OpenElectronicsLab/eeg-mouse-notes/README

Notes and data from the development of the eeg-mouse project

git@github.com:ericherman/eeg-mouse.git
