OpenElectronicsLab/eeg-mouse-notes/images/OpenHardwareExG-family-picture-800px.jpg

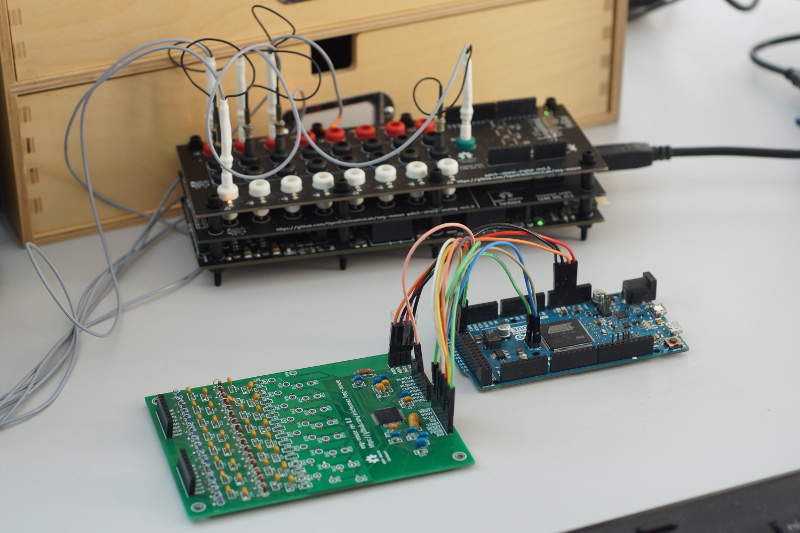
images/OpenHardwareExG-family-picture-800px.jpg
