OpenElectronicsLab/eeg-mouse-notes/images/OpenHardwareExG_rev0.0_level-shifter_arduino-mega.800.jpg

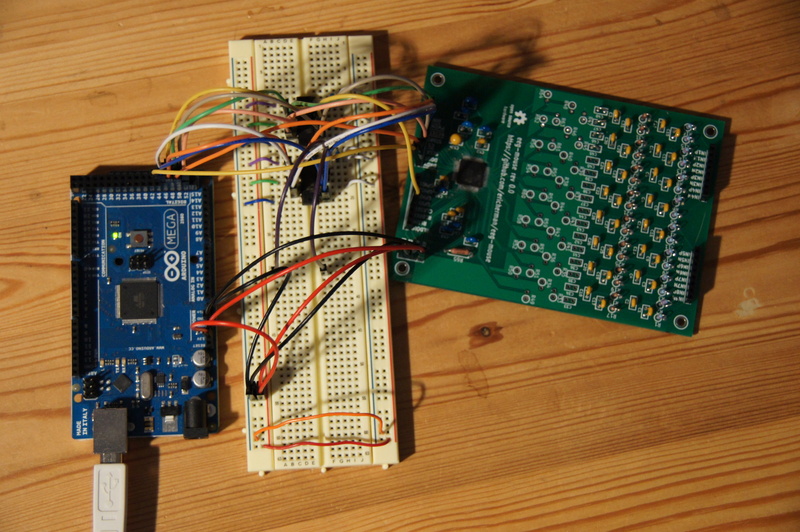
images/OpenHardwareExG_rev0.0_level-shifter_arduino-mega.800.jpg
