OpenElectronicsLab/eeg-mouse-notes/images/rev0-and-due-800px.jpg

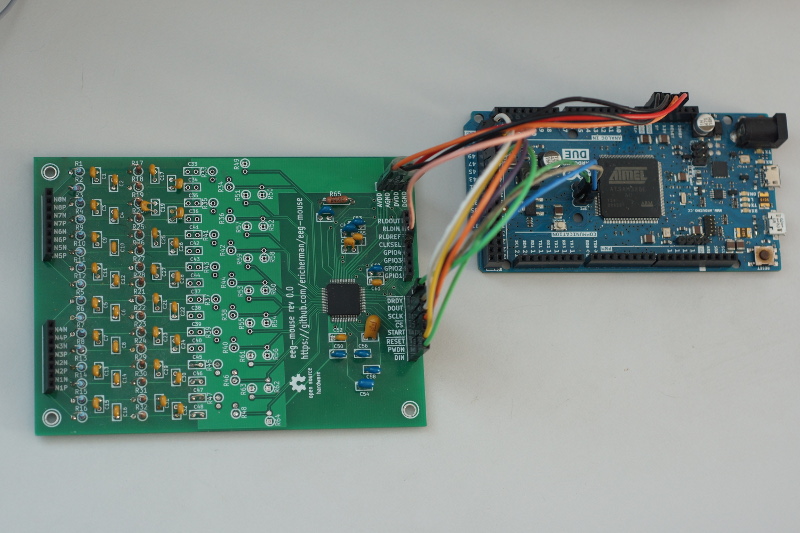
images/rev0-and-due-800px.jpg
