OpenElectronicsLab/eeg-mouse-notes/images/rev1-stack-800px.jpg

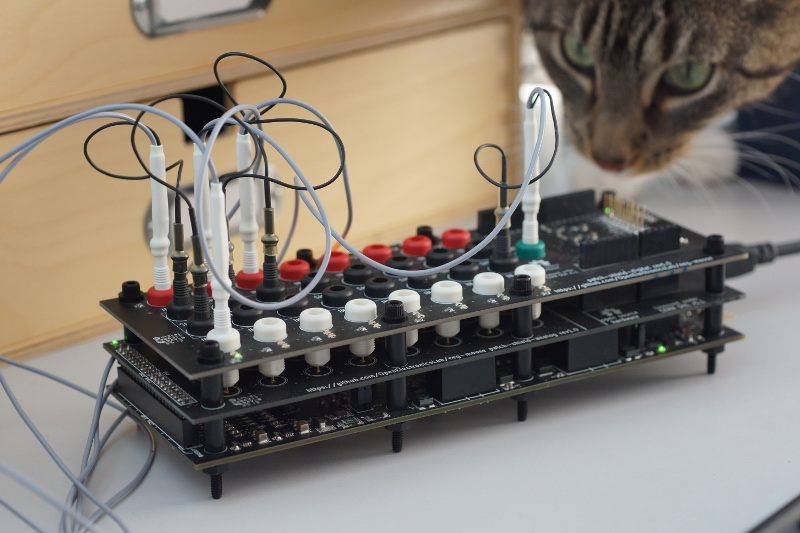
images/rev1-stack-800px.jpg
