OpenElectronicsLab/eeg-mouse-notes/sandbox/ecg.png

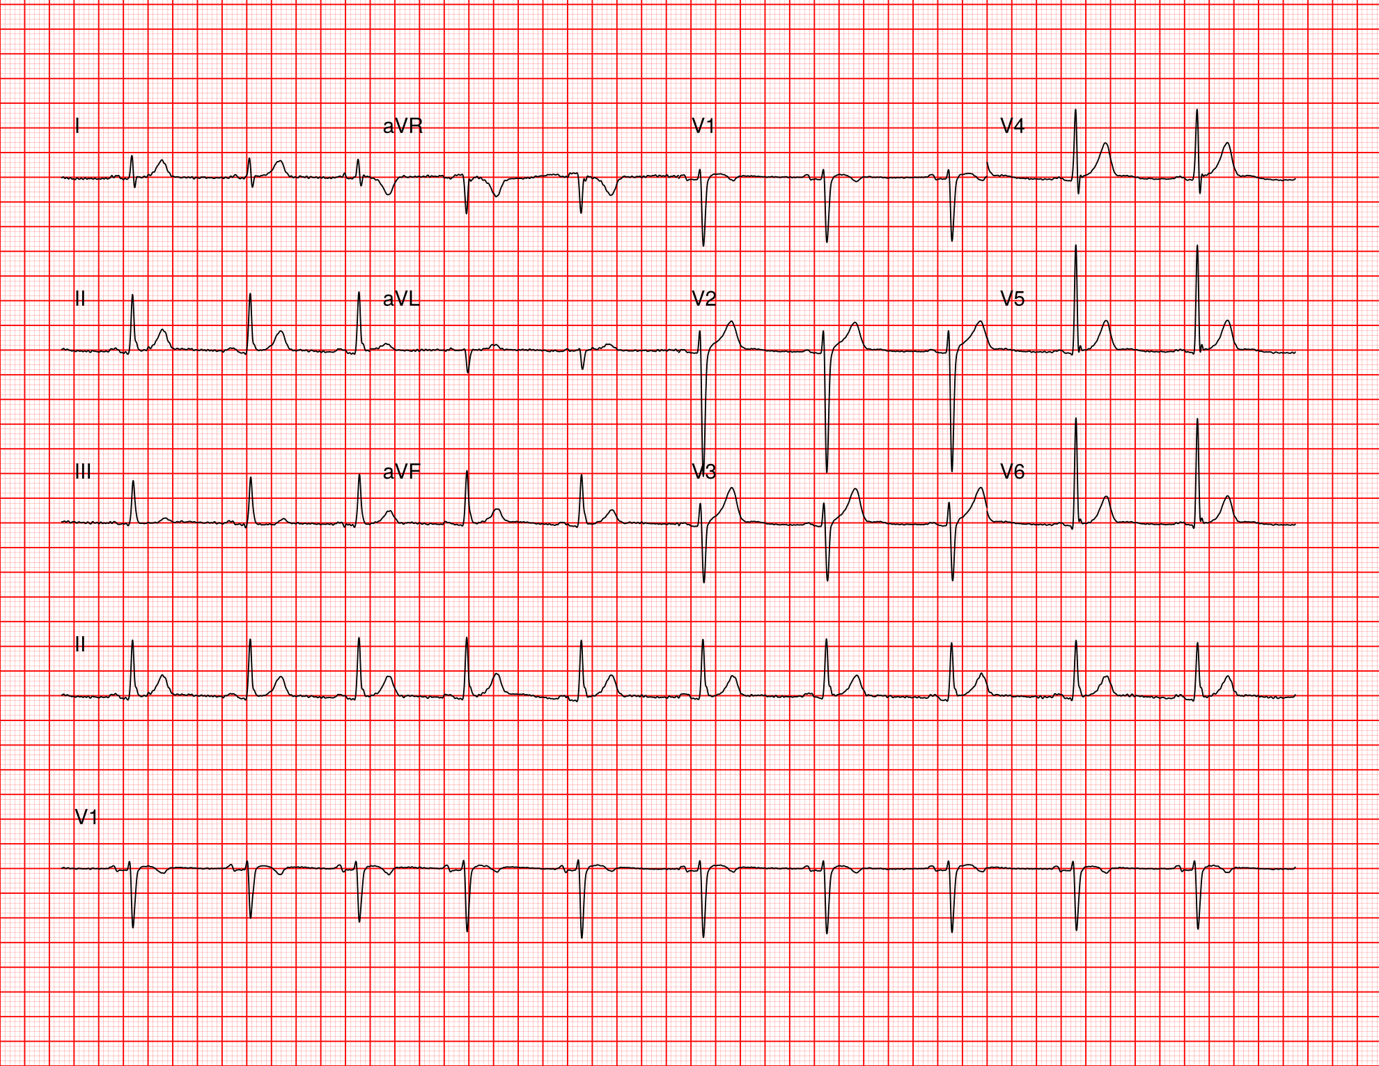
sandbox/ecg.png
