OpenElectronicsLab/eeg-mouse-notes/images/OpenHardwareExG-rev1-soldered.800.jpg

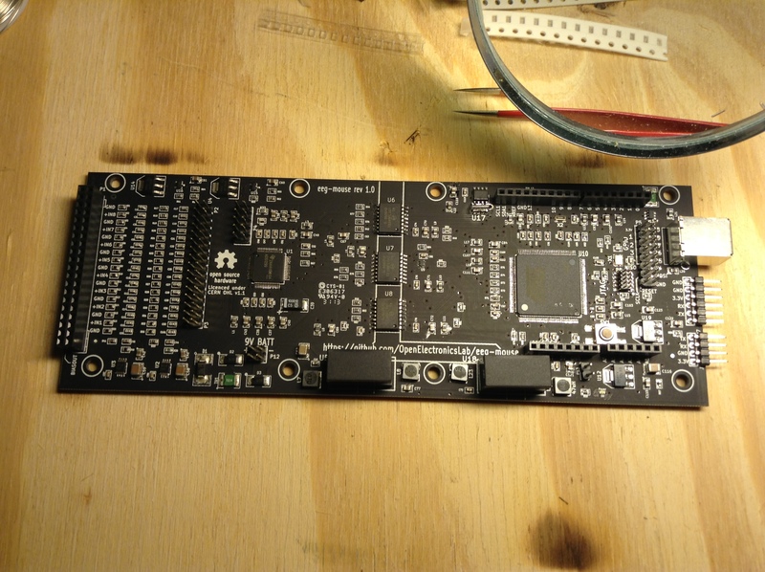
images/OpenHardwareExG-rev1-soldered.800.jpg
