OpenElectronicsLab/eeg-mouse-notes/sandbox/ecg.pdf

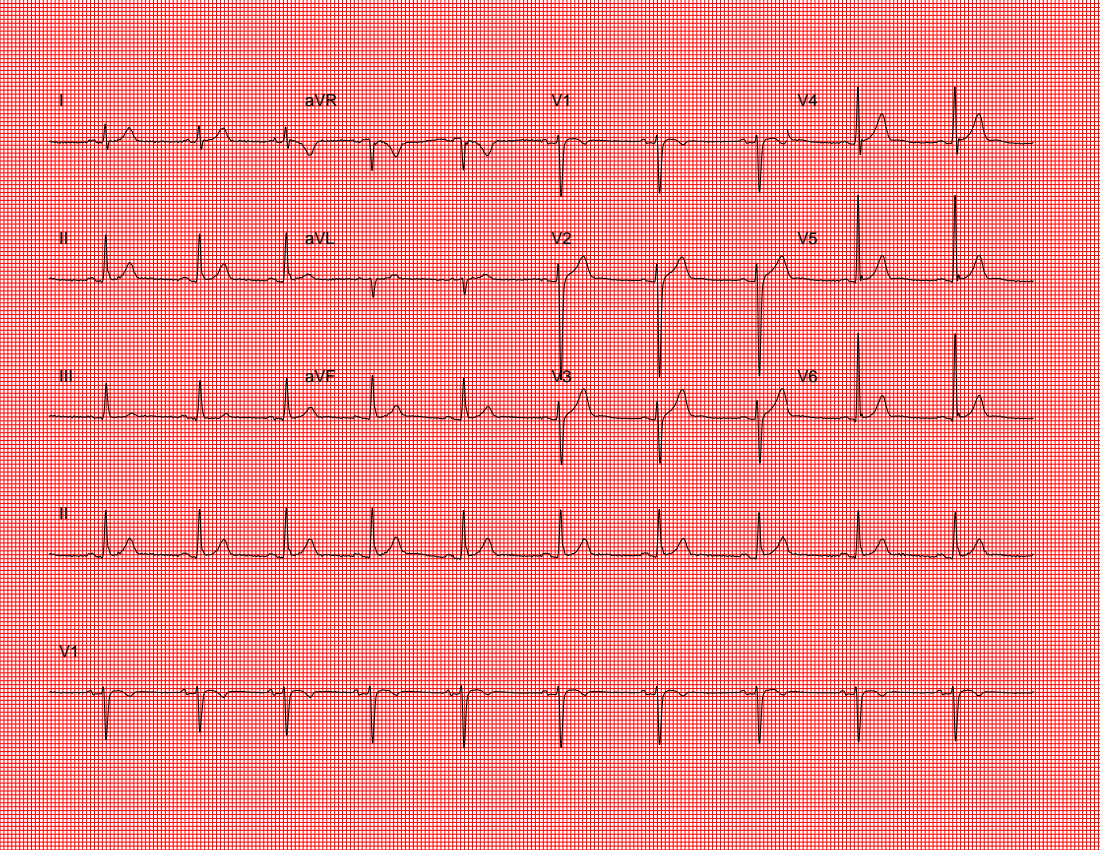
[picture p30: page 1]
III; aVR; aVL; aVF
