OpenElectronicsLab/eeg-mouse-notes/(commit log)

2012-12-01 added "data" directory from eeg-mouse
    [closed1.csv, closed2.csv, closed3.csv, closed4.csv, closed5.csv, closed6.csv, eat-drink.csv, eog0.csv]
2012-12-15 data files from trial with mean distance of 44!
    [trial-kms15-20121215.154356.csv]
2013-01-12 found/fixed problem with NL board
2013-05-05 rev1 schematic; what about timers?
2013-05-25 notes about connector shield
2013-05-25 LED notes
2013-08-03 notes for grounding improvements for next board rev
2013-08-03 filter ideas notes
2013-08-03 order for netherlands boards
2013-08-14 added DIN connector order
2013-08-28 added stencil and boards
2013-10-26 calculated alternative filter options
2013-11-09 make some notes about our filter simulation
2013-11-30 added notes from soldering board
2013-11-30 add comment about erase button
2013-12-01 added images of assembled boards
2014-01-11 add note about moving status LED
2014-01-13 added sample data for ECG
    [ecg-electrodes.csv]
2014-01-25 Ace has working board; fixed D1 footprint
2014-01-26 updated ECG sample to plot on standard ECG grid
2014-02-01 add arduino example to blink several pins and LED
2014-02-01 diagnostics on Ace's board
2014-02-09 new ECG trace at 500 SPS
    [ecg-electrodes.csv]
2014-05-10 add OpenSCAD case notes
2014-05-10 add image of rev1 board inside case
2014-05-24 finally fixed the problem with the LEDs, discussed hardware test plans
2014-05-31 maybe narrow filters are barking up the wrong tree ... perhaps try wider
2014-07-12 add picture of rev0 board with arduino mega and level-shifter
2014-07-12 Add bilinear filter notes, update log
2014-07-16 add section on high pass filter
2014-07-25 start of order 2n high pass filter derivation
2014-07-26 complete first draft of highpass filter of order 2n section
2014-07-26 additional high-pass filter notes and cleanup
2014-08-02 add lowpass filter equations
2014-08-09 save data file from demo video
    [2014-08-09T151657Z_EEG_demo.csv]
2014-08-11 added a Makefile for bilinear-filter-notes tex->pdf
2014-08-17 add pdf of 12-lead ECG
    This PDF is generated from ecg-electrodes.csv by ecg-samples.R
2015-07-18 OpenHardwareExG_Shield prototype expenses
2015-08-01 spice file with fragment of 5.5v crowbar circuit
2015-10-12 notes from active electrode research
2015-10-24 updated active electrode design notes
2015-10-31 active electrode component layout
2016-04-02 spice file showing expected voltage of SIGNAL_A ladder negatives connected
    If we can tie all the negatives together with SRB1, then we will add
    the resistance of the anti-alias filters to the ladder.
    Using bc, we calculate IN8N without the SRB as:
    $ bc <<< "scale=20; (((100*15)+15000)/(15000 + (100 * 15) + 15000)) * 3.3"
    1.72857142857142857141
    This matches ngspice to 6 sigfigs.
    Using ngspice, and adding the SRB we see the following:
    Node Voltage
    ---- -------
    vcc 3.3
    siga 3.3
    sigb 1.05626e-07
    in8n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
